joebell/LEDboard/DualLEDPanel v1.brd

## EAGLE design DualLEDPanel v1.brd (2014-03-22)

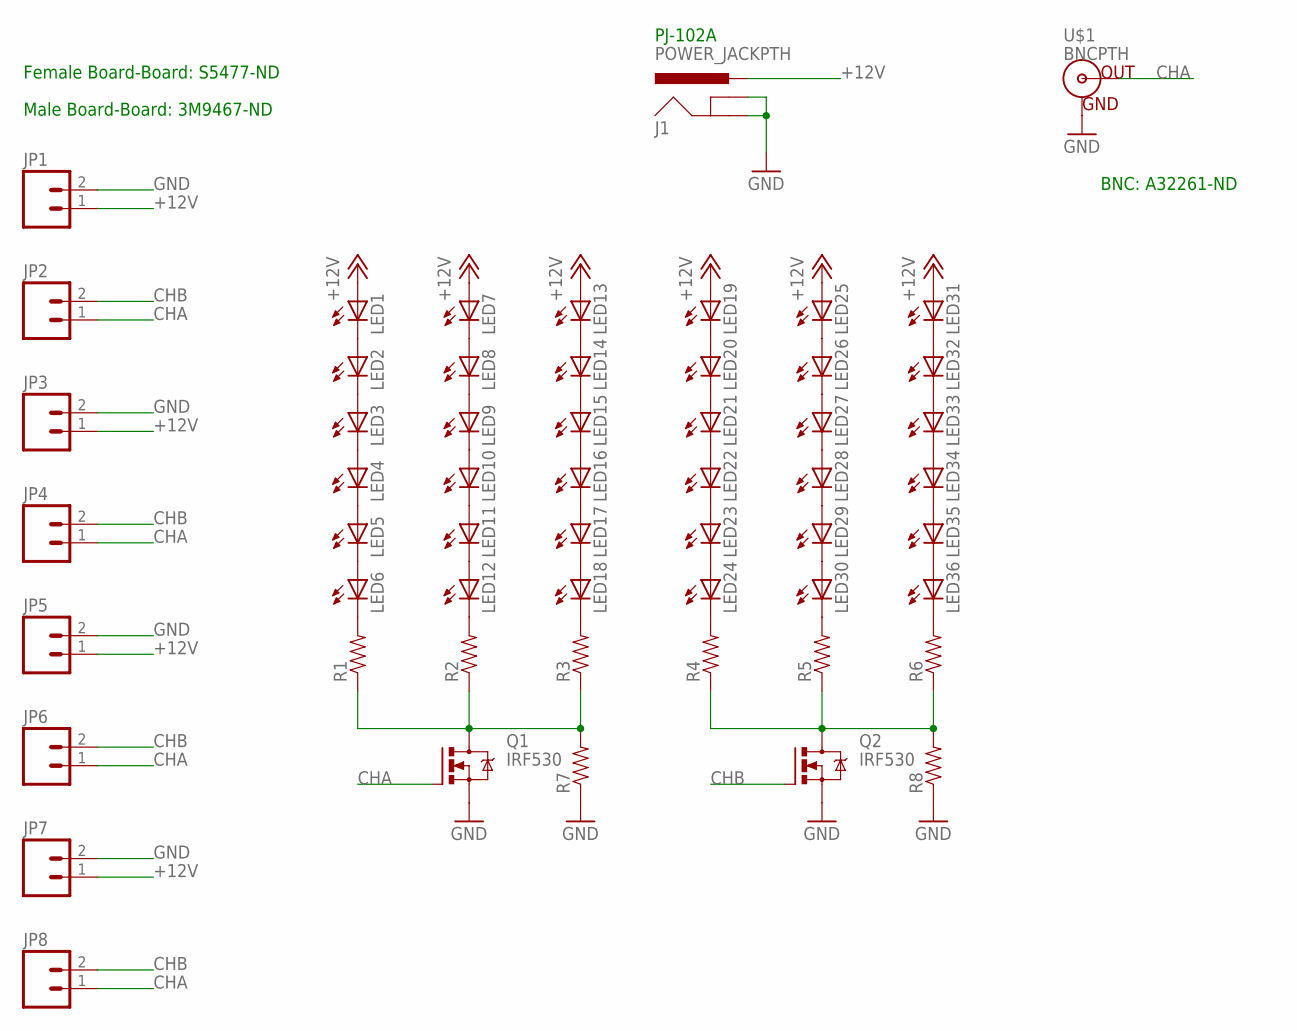
[picture p1: schematic DualLEDPanel v1.sch]

Parts:
J1: POWER_JACKPTH; POWER_JACK_PTH
JP1, JP2, JP3, JP4, JP5, JP6, JP7, JP8: M02PTH; 1X02
LED1, LED2, LED3, LED4, LED5, LED6, LED7, LED8, LED9, LED10, LED11, LED12, LED13, LED14, LED15, LED16, LED17, LED18, LED19, LED20, LED21, LED22, LED23, LED24, LED25, LED26, LED27, LED28, LED29, LED30, LED31, LED32, LED33, LED34, LED35, LED36: LED5MM
Q1, Q2: IRF530; TO220BV
R1, R2, R3, R4, R5, R6, R7, R8: RESISTORPTH-1/4W; AXIAL-0.4
U$1: BNCPTH; BNC

Connections:
+12V: J1.PWR, JP1.1, JP3.1, JP5.1, JP7.1, LED1.A, LED7.A, LED13.A, LED19.A, LED25.A, LED31.A
CHA: JP2.1, JP4.1, JP6.1, JP8.1, Q1.G, U$1.S (OUT)
CHB: JP2.2, JP4.2, JP6.2, JP8.2, Q2.G
GND: J1.GND, J1.GNDBREAK, JP1.2, JP3.2, JP5.2, JP7.2, Q1.S, Q2.S, R7.P$1 (1), R8.P$1 (1), U$1.GND
unnamed: LED1.K (C), LED2.A
unnamed: LED2.K (C), LED3.A
unnamed: LED3.K (C), LED4.A
unnamed: LED4.K (C), LED5.A
unnamed: LED5.K (C), LED6.A
unnamed: LED6.K (C), R1.P$2 (2)
unnamed: LED7.K (C), LED8.A
unnamed: LED8.K (C), LED9.A
unnamed: LED9.K (C), LED10.A
unnamed: LED10.K (C), LED11.A
unnamed: LED11.K (C), LED12.A
unnamed: LED12.K (C), R2.P$2 (2)
unnamed: LED13.K (C), LED14.A
unnamed: LED14.K (C), LED15.A
unnamed: LED15.K (C), LED16.A
unnamed: LED16.K (C), LED17.A
unnamed: LED17.K (C), LED18.A
unnamed: LED18.K (C), R3.P$2 (2)
unnamed: LED19.K (C), LED20.A
unnamed: LED20.K (C), LED21.A
unnamed: Q1.D, R1.P$1 (1), R2.P$1 (1), R3.P$1 (1), R7.P$2 (2)
unnamed: LED21.K (C), LED22.A
unnamed: LED22.K (C), LED23.A
unnamed: Q2.D, R4.P$1 (1), R5.P$1 (1), R6.P$1 (1), R8.P$2 (2)
unnamed: LED23.K (C), LED24.A
unnamed: LED24.K (C), R4.P$2 (2)
unnamed: LED25.K (C), LED26.A
unnamed: LED26.K (C), LED27.A
unnamed: LED27.K (C), LED28.A
unnamed: LED28.K (C), LED29.A
unnamed: LED29.K (C), LED30.A
unnamed: LED30.K (C), R5.P$2 (2)
unnamed: LED31.K (C), LED32.A
unnamed: LED32.K (C), LED33.A
unnamed: LED33.K (C), LED34.A
unnamed: LED34.K (C), LED35.A
unnamed: LED35.K (C), LED36.A
unnamed: LED36.K (C), R6.P$2 (2)

Notes on the sheet:
Female Board-Board: S5477-ND
Male Board-Board: 3M9467-ND
BNC: A32261-ND
PJ-102A

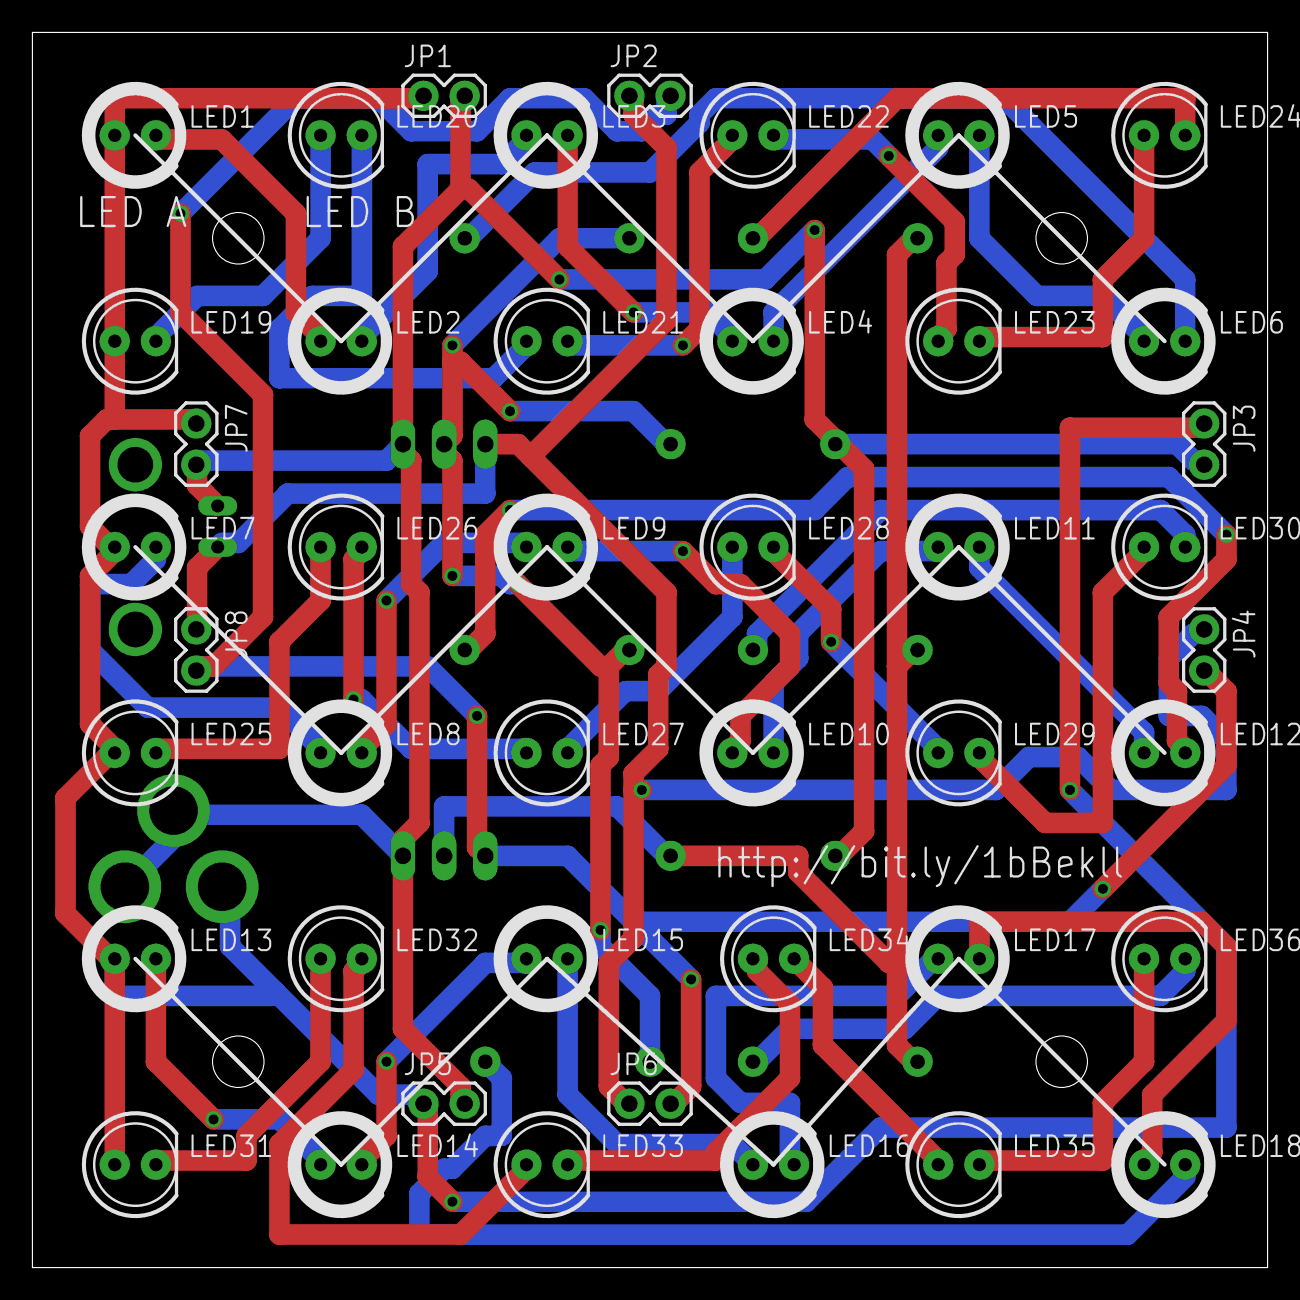
[picture p2: board DualLEDPanel v1.brd from above]

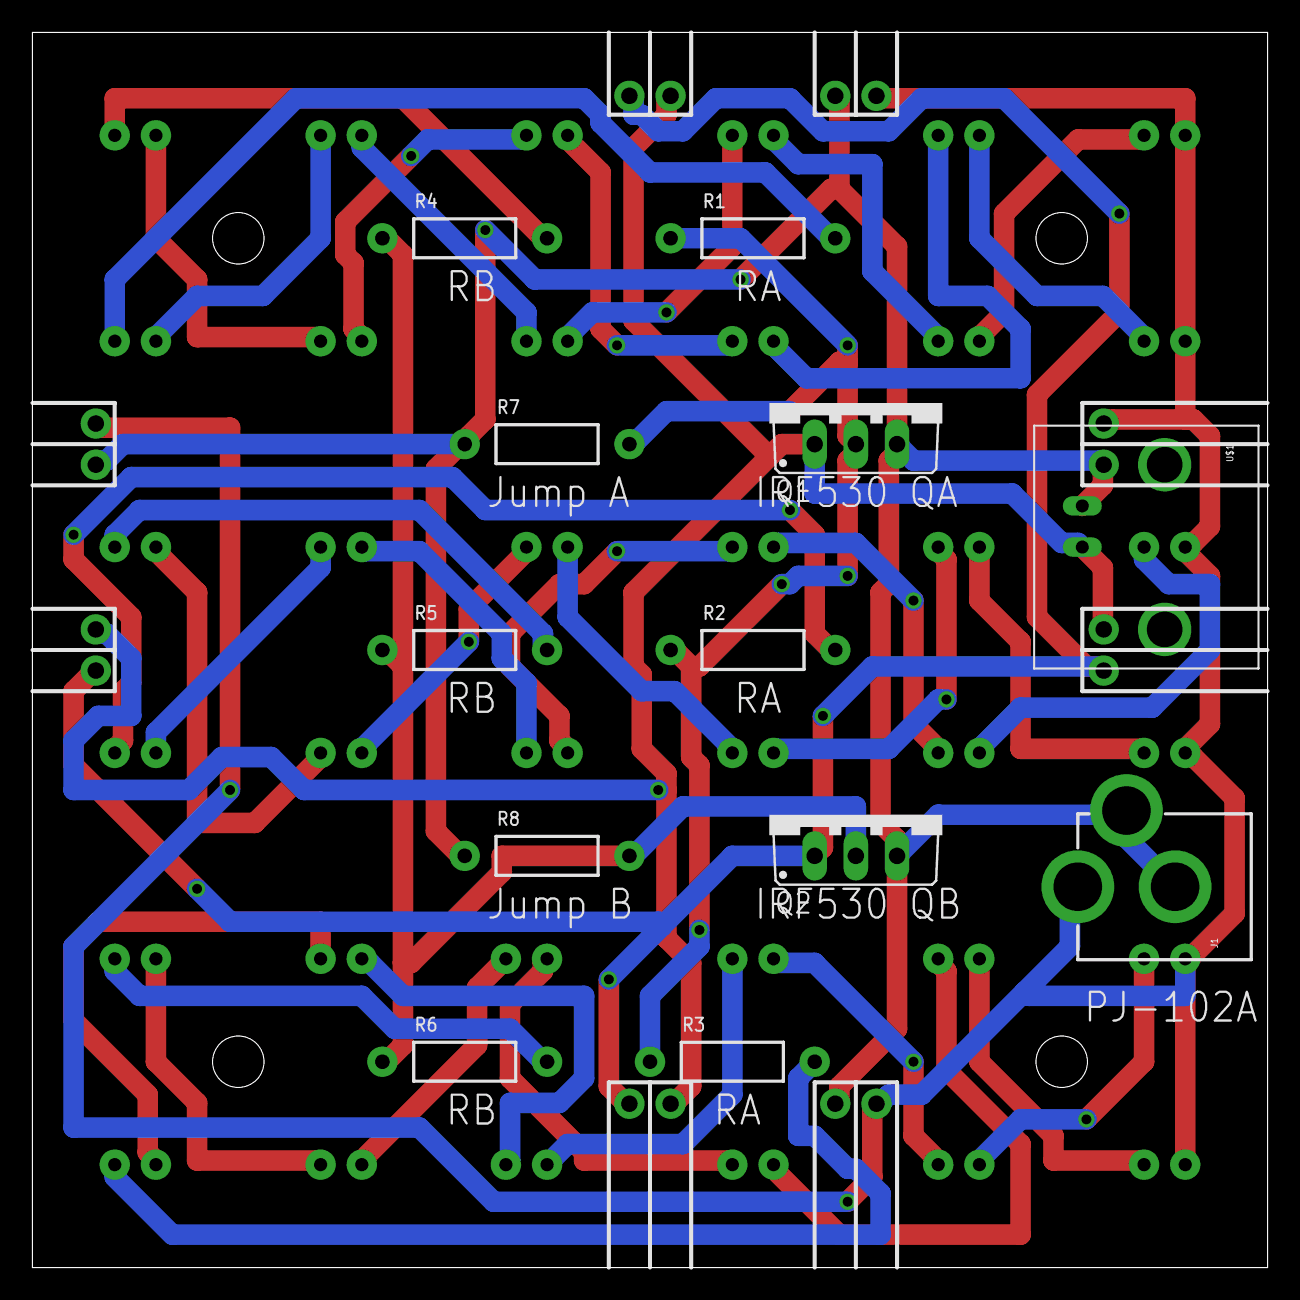
[picture p3: board DualLEDPanel v1.brd from below]

Board: 2 copper layers, 76.2 x 76.2 mm, 56 parts (12 on the bottom side), 42 nets.
