joebell/LEDboard/LEDboardInstructions.rtf

Dual Color LED Field Board URL - http://bit.ly/1bBekll

This circuit allows tiling of switchable and diffuse LED light. Each tile has two switchable circuits, (eg. blue and IR). It’s built for standard 5 mm through-hole LEDs. Each 3”x3” panel has 18 LEDs of each color. It also has room for a 2.1mm power connector, and a standard BNC input. The board edges plug together using .1” header pins that share the power, ground, and switching signals. It also has ⅛” diameter mounting holes ½” from each corner. (These work well with 4-40 threaded standoffs.)

Each of the 2 channels has 3 series strings of 6 LEDs, with a series resistor to limit current. Both channels are switchable, but only channel A has its switching input brought out to a BNC connector. Most of the time, a wire can be placed across the connection (Jump B) to keep channel B on all the time. If you need to switch both channels, use one of the .1” header pins that can be used to tile the boards to get signals in.

The blue LEDs want 20 mA at 3.2 V each, the IR LEDs can take up to 100 mA at 1.5 V. Use this info to choose suitable series resistor values for each channel, given the power supply. For example, with a 24 V power supply, we want the blue LEDs to drop 6*3.2V = 18.8 V, so the blue series resistors should drop 24 V - 18.8 V = 4.2 V at 20 mA, so about 200 ohms.

We want the IR leds to drop 9 V, so the resistor would need to drop 15 V at 100 mA. This would dissipate 1.8 W of power, which is too much for the resistor to handle. (It would also be crazy bright.) Let’s allow the resistor to dissipate about 1 W at 330 ohms.

With a 12 V supply the IR LEDs are more comfortable. A 50 ohm resistor allows 60 mA of current with a 3 V drop. A standard ¼ watt resistor will work fine.

Feel free to use different LED / resistor / supply voltage combinations. The LED lead spacing is for standard 5mm T1¾ package through-hole LEDs.

Building the Boards:

If you only want 1 or 2, you may be able to get them from the Wilson Lab. Otherwise, you’ll need to fabricate your own.

Files are available here: https://drive.google.com/file/d/0B7uBwBiCIUHtOEZrYVBxNmMxME0/edit?usp=sharing

The zip file contains the Eagle schematics and board layout, as well as a directory with all of the gerber files necessary for fabrication. Of note are:

.top | Top copper traces
.bot | Bottom copper traces
.oln | Board outline
.slk | Top silkscreen
.smt | Top soldermask
.smb | Bottom soldermask
.drd | NC drill data
.bsk | Bottom silkscreen

You can upload these to a PCB fab house to have a small number of boards made. I like Sunstone and Silvercircuits.

Because building these requires putting components on both sides of the board, I strongly recommend printing both the top and bottom silkscreen. This will cost a bit more, but save you a ton of time and hassle from soldering components onto the wrong places.

You’ll also need to buy parts. They’re all available at Digikey. Remember that you’ll only need a BNC connector and power supply for one board in each assembly - the others receive signals and power through their edge connectors.

Parts: (per each 3”x3” panel)

Description: | Digikey Part: | Qty:
Female header connector | S5477-ND | 4
Male header connector | 3M9467-ND | 4
BNC connector (optional) | A32261-ND | 1
Power connector (2.1mm, optional) | PJ-102A | 1
IR LED (860 nm) | 475-3003-ND | 18
Blue LED (470 nm) | C503B-BCN-CV0Z0461-ND | 18
IR channel series resistors, 330 ohm | PPC330W-1CT-ND | 6
Blue channel series resistors, 200 ohm | CF14JT200RCT-ND | 6
FET Switch | IRF530 | 2

Building the boards:

Pay special attention to the order of operations here. Some parts occlude the spots where others need to be soldered.

(1) Place transistors first, paying attention to the polarity. (If you won’t use the switching feature, you don’t need them.

(2) Add the 3 resistors for each channel.

(3) If you won’t be switching a channel and want it to be on all the time, connect a wire across the JUMP location.

(4) Now solder in the LEDs. Pay attention to polarity here too! (Note the shape of the silkscreen - the flatted part of the LED points right.) Also make sure you get the right color LED in the right channel. The colors are arranged in an intercolated diamond pattern, with Channel A having thick silkscreen, and Channel B having thin silkscreen.

(5) Add the connectors last. You won’t be able to use both a BNC channel A switching input and the edge connector on that side. Facing the LED side, the male edge connectors go on the top and right edges of the board, the female connectors go on the bottom and left edges.
